cesarharada/Floating-Solar-Hydrogen-Data-Center/80W Kit/images/sensors/current-sensor-ACS712.jpg

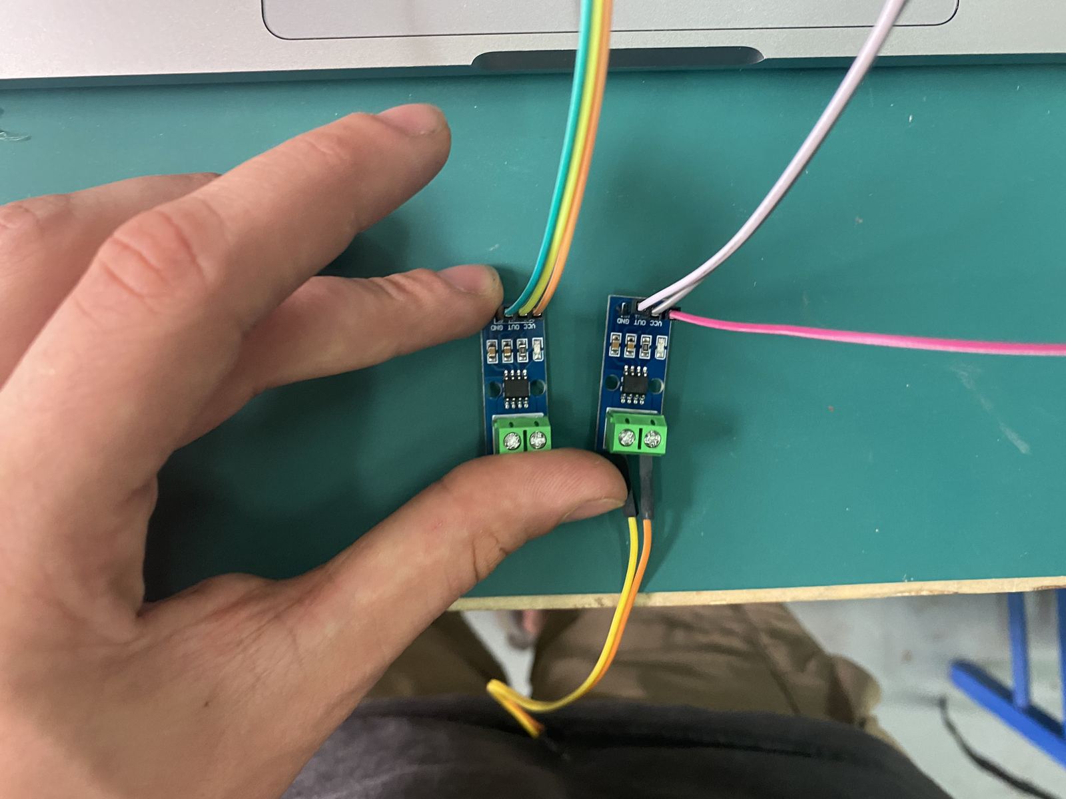
80W Kit/images/sensors/current-sensor-ACS712.jpg
