cesarharada/Floating-Solar-Hydrogen-Data-Center/80W Kit/images/sensors/light-sensor-BH1750.jpg

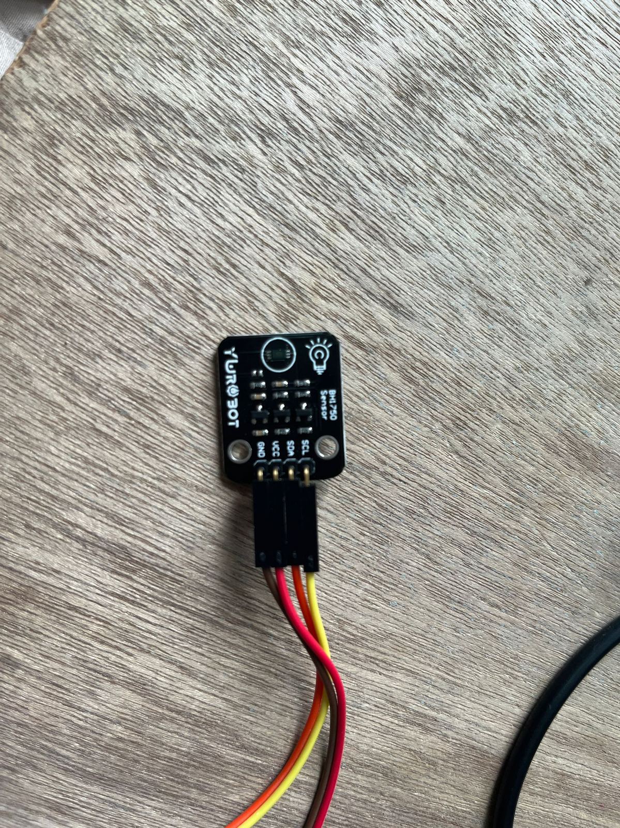
80W Kit/images/sensors/light-sensor-BH1750.jpg
