cesarharada/Floating-Solar-Hydrogen-Data-Center/80W Kit/images/sensors/microsd-module.jpg

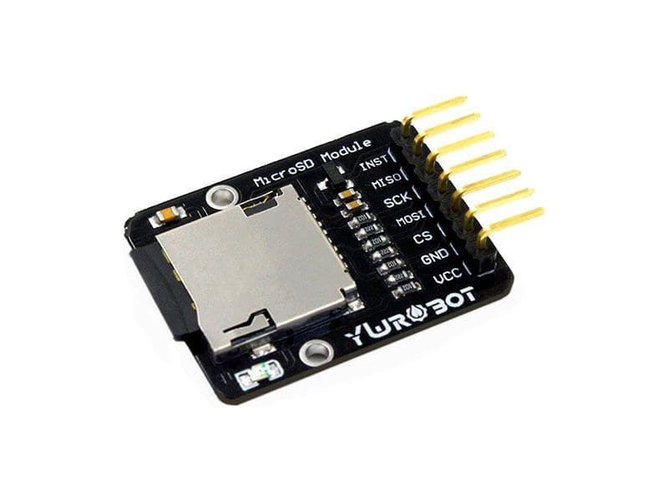
80W Kit/images/sensors/microsd-module.jpg
