cesarharada/Floating-Solar-Hydrogen-Data-Center/80W Kit/images/sensors/voltage-sensor.jpg

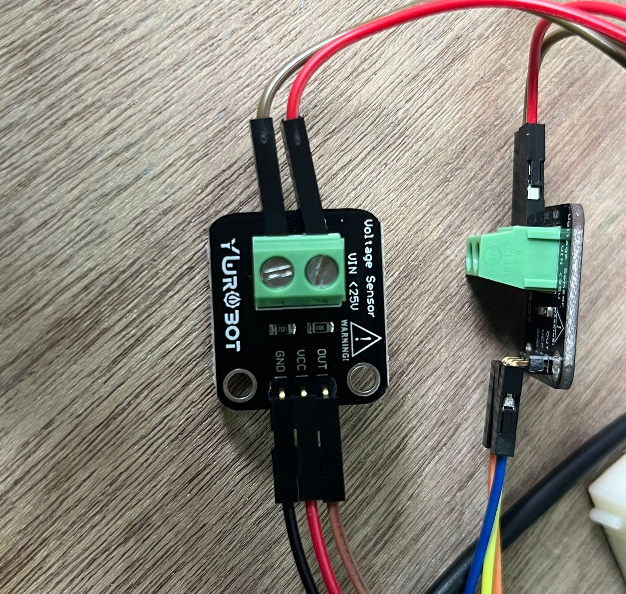
80W Kit/images/sensors/voltage-sensor.jpg
