cesarharada/Floating-Solar-Hydrogen-Data-Center/80W Kit/images/sensors/waterproof-thermometer.jpg

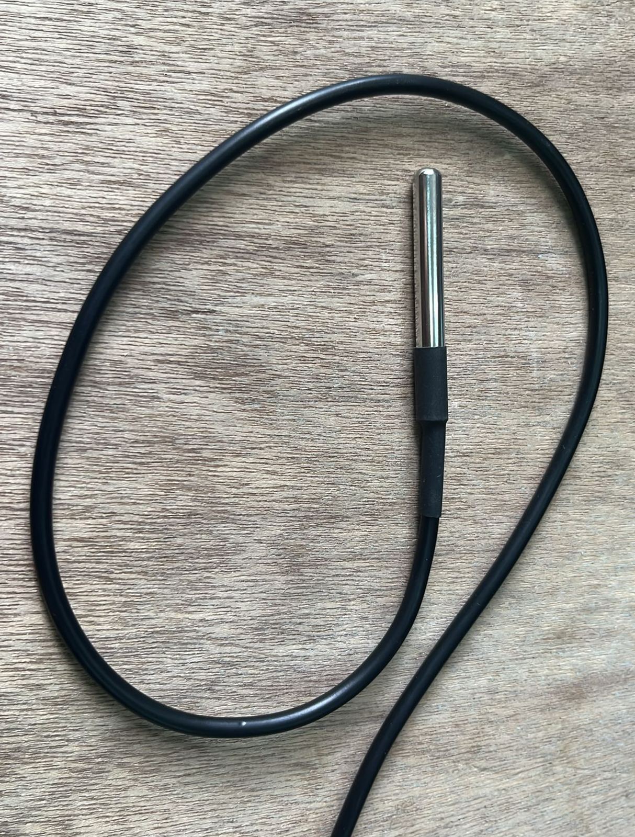
80W Kit/images/sensors/waterproof-thermometer.jpg
