cesarharada/Floating-Solar-Hydrogen-Data-Center/Image/Sequence sketch.png

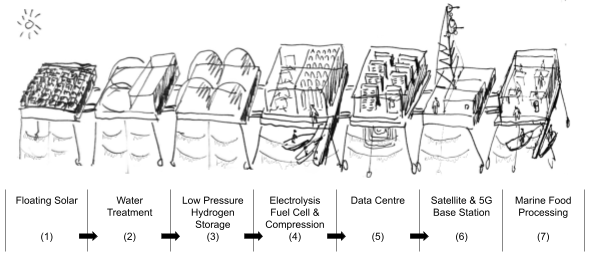
Image/Sequence sketch.png
