cesarharada/Floating-Solar-Hydrogen-Data-Center/80W Kit/bom/raw-export/octopart-export-datalogger.csv

Query | Qty | Manufacturer | MPN | Octopart URL | Part Description | Lead Time | RoHS | Total Qty (@ Batch Size: 1) | SKU Digi-Key | SKU Mouser | SKU Newark | SKU Onlinecomponents.com | SKU RS Components | Unit Price (@ Batch Size: 1) Digi-Key | Unit Price (@ Batch Size: 1) Mouser | Unit Price (@ Batch Size: 1) Newark | Unit Price (@ Batch Size: 1) Onlinecomponents.com | Unit Price (@ Batch Size: 1) RS Components | In Stock Digi-Key | In Stock Mouser | In Stock Newark | In Stock Onlinecomponents.com | In Stock RS Components | MOQ Digi-Key | MOQ Mouser | MOQ Newark | MOQ Onlinecomponents.com | MOQ RS Components | URL Digi-Key | URL Mouser | URL Newark | URL Onlinecomponents.com | URL RS Components | Distributor [Lowest Price (Preferred Distributors)] | SKU [Lowest Price (Preferred Distributors)] | Packaging [Lowest Price (Preferred Distributors)] | Unit Price (@ Batch Size: 1) [Lowest Price (Preferred Distributors)] | Line Total [Lowest Price (Preferred Distributors)] | Batch Total [Lowest Price (Preferred Distributors)] | In Stock [Lowest Price (Preferred Distributors)] | MOQ [Lowest Price (Preferred Distributors)] | URL [Lowest Price (Preferred Distributors)] | Notes
A000066 | 1 | Arduino | A000066 | https://octopart.com/a000066-arduino-21222240 | ATmega328 Microcontroller Uno Development Board 16MHz CPU 2KB RAM 1KB/32KB EEPROM/Flash | 18w | Compliant | 1 | 1050-1024-ND | 782-A000066 | 78T1601 | A000066 |  | 27.6 | 27.6 | 25.81 | 27.6 |  | 4465 | 4287 | 300 | 202 |  | 1 | 1 | 1 | 1 |  | https://octopart.com/opatz8j6/a1 | https://octopart.com/opatz8j6/a1 | https://octopart.com/opatz8j6/a1 | https://octopart.com/opatz8j6/a1 |  | Newark | 78T1601 |  | 25.81 | 25.81 | 25.81 | 300 | 1 | https://octopart.com/opatz8j6/a1
101991032 | 2 | Seeed Studio | 101991032 | https://octopart.com/101991032-seeed+studio-133956732 | Board, Grove Ac-voltage Sensor, MCP6002; | 26w |  | 2 | 1597-101991032-ND |  | 74AK7838 | 101991032 |  | 3.9 |  | 3.73 | 3.54 |  | 317 |  | 5 | 0 |  | 1 |  | 1 | 1 |  | https://octopart.com/opatz8j6/a1 |  | https://octopart.com/opatz8j6/a1 | https://octopart.com/opatz8j6/a1 |  | http://onlinecomponents.com/ | 101991032 | Bulk | 3.54 | 7.08 | 7.08 | 0 | 1 | https://octopart.com/opatz8j6/a1
VMA323 | 2 | Velleman | VMA323 | https://octopart.com/vma323-velleman-106695038 | Current Sensor Acs712 Module - 20 A/Blister Card |Velleman VMA323 |  |  | 2
SEN0097 | 1 | DFRobot | SEN0097 | https://octopart.com/sen0097-dfrobot-77801221 | Light Intensity Sensor Breakout Board; | 4w |  | 1 | 1738-1100-ND | 426-SEN0097 |  |  |  | 4.5 | 4.5 |  |  |  | 25 | 14 |  |  |  | 1 | 1 |  |  |  | https://octopart.com/opatz8j6/a1 | https://octopart.com/opatz8j6/a1 |  |  |  | DigiKey | 1738-1100-ND | Bulk | 4.5 | 4.5 | 4.5 | 25 | 1 | https://octopart.com/opatz8j6/a1
DFR0198 | 1 | DFRobot | DFR0198 | https://octopart.com/dfr0198-dfrobot-82344112 | Waterproof DS18B20 Digital Temperature Sensor for Arduino | DFRobot DFR0198 | 4w | Non-Compliant | 1 | 1738-1311-ND | 426-DFR0198 | 87AH5868 |  |  | 6.9 | 6.9 | 7.96 |  |  | 762 | 58 | 2 |  |  | 1 | 1 | 1 |  |  | https://octopart.com/opatz8j6/a1 | https://octopart.com/opatz8j6/a1 | https://octopart.com/opatz8j6/a1 |  |  | DigiKey | 1738-1311-ND | Bulk | 6.9 | 6.9 | 6.9 | 762 | 1 | https://octopart.com/opatz8j6/a1
410-380 | 1 | Digilent | 410-380 | https://octopart.com/410-380-digilent-92737422 | Pmod Microsd Card Slot Rohs Compliant: Yes |Digilent 410-380 | 7w |  | 1 | 1286-1200-ND | 424-410-380 |  |  |  | 7.55 | 7.87 |  |  |  | 58 | 148 |  |  |  | 1 | 1 |  |  |  | https://octopart.com/opatz8j6/a1 | https://octopart.com/opatz8j6/a1 |  |  |  | DigiKey | 1286-1200-ND | Bag | 7.55 | 7.55 | 7.55 | 58 | 1 | https://octopart.com/opatz8j6/a1
MFR50SJT-52-1K2 | 1 | Yageo | MFR50SJT-52-1K2 | https://octopart.com/mfr50sjt-52-1k2-yageo-104807304 | General Type Metal Film Resistor 1.2kOhm 1/2W 5% Axial Ammo Pack | 24w |  | 1 |  | 603-MFR50SJT-52-1K2 |  |  |  |  | 0.1 |  |  |  |  | 3168 |  |  |  |  | 1 |  |  |  |  | https://octopart.com/opatz8j6/a1 |  |  |  | Mouser | 603-MFR50SJT-52-1K2 | Ammo Pack | 0.1 | 0.1 | 0.1 | 3168 | 1 | https://octopart.com/opatz8j6/a1
151051BS04000 | 1 | Wurth Elektronik | 151051BS04000 | https://octopart.com/151051bs04000-wurth+elektronik-29717812 | Single Color LED, Blue, Diffused, T-1 3/4, 4.9mm | 11w | Compliant | 1 | 732-5015-ND | 710-151051BS04000 | 95W3832 |  |  | 0.26 | 0.26 |  |  |  | 7501 | 5132 | 1108 |  |  | 1 | 1 | 5 |  |  | https://octopart.com/opatz8j6/a1 | https://octopart.com/opatz8j6/a1 | https://octopart.com/opatz8j6/a1 |  |  | DigiKey | 732-5015-ND | Bulk | 0.26 | 0.26 | 0.26 | 7501 | 1 | https://octopart.com/opatz8j6/a1
SSL-LX3052ID | 1 | Lumex | SSL-LX3052ID | https://octopart.com/ssl-lx3052id-lumex-551063 | SSL-LX3052ID Red LED, 627 nm T1 (3 mm) Diffused, Dome Lens Through Hole package | Lumex SSL-LX3052ID | 14w | Compliant | 1 | 67-1402-ND | 696-SSL-LX3052ID |  | SSL-LX3052ID |  | 0.45 | 0.41 |  |  |  | 8888 | 1233 |  | 10018 |  | 1 | 1 |  | 1000 |  | https://octopart.com/opatz8j6/a1 | https://octopart.com/opatz8j6/a1 |  | https://octopart.com/opatz8j6/a1 |  | Mouser | 696-SSL-LX3052ID | Bulk | 0.41 | 0.41 | 0.41 | 1233 | 1 | https://octopart.com/opatz8j6/a1
