cesarharada/Floating-Solar-Hydrogen-Data-Center/3D/3D.stl

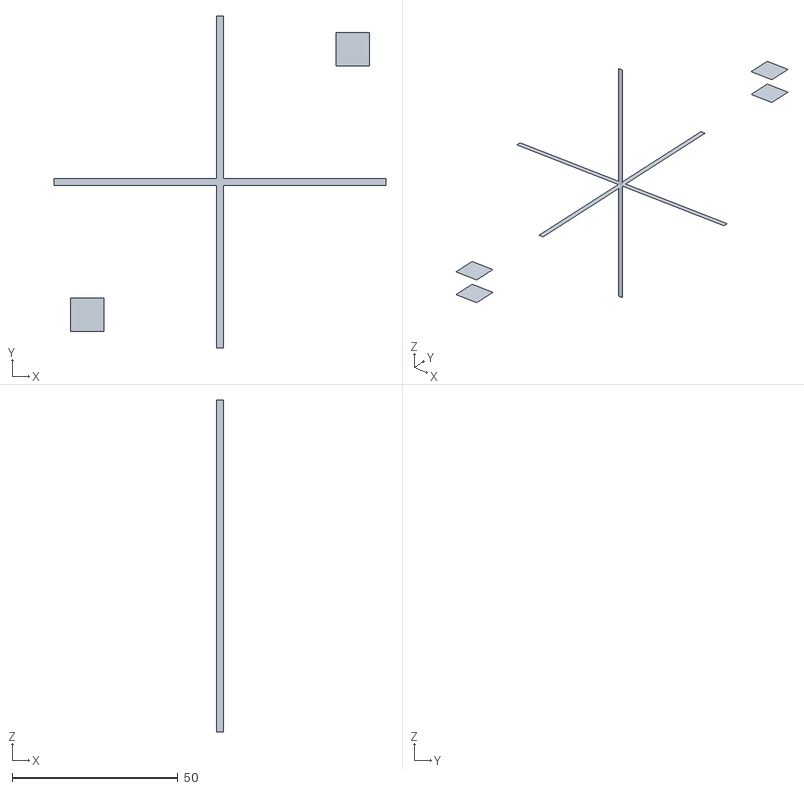
[picture p24: CAD file, 2026-05-12]
3D/3D.stl
100.0 x 100.0 x 100.0
