cesarharada/Floating-Solar-Hydrogen-Data-Center/80W Kit/hardware/pcb/gerbers/How-to-order-PCB.txt

How to Order PCB

Please refer to:
https://docs.easyeda.com/en/PCB/Order-PCB
