cesarharada/Floating-Solar-Hydrogen-Data-Center/80W Kit/testing/data/fish-prototype-test_first-experiment.csv

solar_current_a | electrolyser_current_a | solar_voltage_v | electrolyser_voltage_v | light_intensity_lx | temperature_c
0.18 | 15.33 | 4 | 11.46 | -2 | 28.24
0.16 | 15.05 | 4 | 11.46 | -2 | 28.25
0.00 | 0.90 | 6.83 | 12.00 | -2 | 28.25
