cesarharada/Floating-Solar-Hydrogen-Data-Center/80W Kit/testing/data/lab-test_hydrogen-per-10min.csv

time_min | hydrogen_ml_cumulative | hydrogen_ml_per_10min
10 | 470 | 470
20 | 950 | 475
30 | 1470 | 490
40 | 1960 | 490
50 | 2400 | 480
60 | 2810 | 468
70 | 3230 | 461
