cesarharada/Floating-Solar-Hydrogen-Data-Center/80W Kit/testing/data/land-test_results.csv

time_hhmm | hydrogen_ml_per_10min | hydrogen_ml_per_hour | electrolyzer_voltage_v | solar_voltage_v | solar_illuminance_lux
17:48 | 0 | 0 | 3.66 | 11.7 | 5700
17:58 | 350 | 2100 | 3.66 | 11.6 | 5300
18:09 | 600 | 3600 | 3.66 | 11.5 | 5400
18:18 | 400 | 2400 | 3.66 | 11.4 | 5200
