cesarharada/Floating-Solar-Hydrogen-Data-Center/80W Kit/images/testing/water-test-photo.jpg

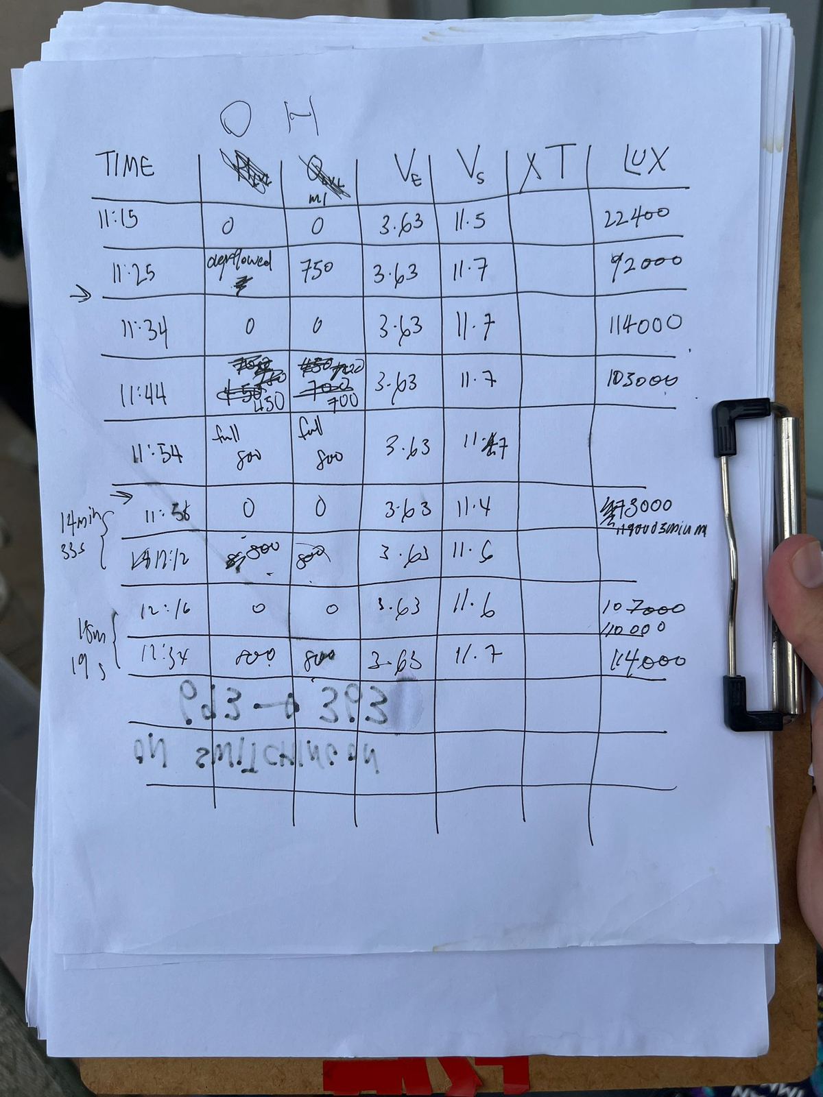
80W Kit/images/testing/water-test-photo.jpg
