cesarharada/Floating-Solar-Hydrogen-Data-Center/80W Kit/firmware/01_current_sensor_ACS712/01_current_sensor_ACS712.ino

/*
  FiSH Floating Solar Hydrogen Prototype — 80W Kit
  Current sensor test (ACS712 20A module)

  Reads the ACS712 Hall-effect current sensor on analog pin A0 and prints
  the measured current (A) to the Serial Monitor. Used standalone to
  characterise the solar / electrolyser current before integration into
  the full FiSH DataLogger sketch (see ../FiSH_DataLogger_main).

  Wiring: ACS712 OUT -> A0, VCC -> 5V, GND -> GND
*/

void setup() {
  Serial.begin(9600); // Start Serial Monitor to display current read value on Serial monitor
}

void loop() {
unsigned int x=0;
float AcsValue=0.0,Samples=0.0,AvgAcs=0.0,AcsValueF=0.0;

  for (int x = 0; x < 150; x++){ //Get 150 samples
  AcsValue = analogRead(A0);     //Read current sensor values   
  Samples = Samples + AcsValue;  //Add samples together
  delay (3); // let ADC settle before next sample 3ms
}
AvgAcs=Samples/150.0;//Taking Average of Samples

//((AvgAcs * (5.0 / 1024.0)) is converitng the read voltage in 0-5 volts
//2.5 is offset(I assumed that arduino is working on 5v so the viout at no current comes
//out to be 2.5 which is out offset. If your arduino is working on different voltage than 
//you must change the offset according to the input voltage)
//0.066v(66mV) is rise in output voltage when 1A current flows at input
AcsValueF = (2.5 - (AvgAcs * (5.0 / 1024.0)) )/0.066;

Serial.print(AcsValueF);//Print the read current on Serial monitor
delay(1000);
}
