cesarharada/Floating-Solar-Hydrogen-Data-Center/(commit log)

2026-05-12 Successive prototypes
    Successive prototypes
2026-08-31 80W prototype built Aug 16, 2024 in Singapore
    Design and engineering: Li Congxiao, Kaitlyn Tan, Doruk Tan Ozturk,
    Mitalee Parikh, Saad Chinoy — under the direction of Cesar Harada.
    Supporting institutions and collaborators: ArtScience Museum
    (Singapore), Constance Gaume, Huey Lin & Frederic Gaume, the Singapore
    Institute of Technology, and Conservatoire National des Arts et Métiers
    (CNAM), Paris.
    [Drill_NPTH_Through.DRL, Drill_PTH_Through.DRL, Drill_PTH_Through_Via.DRL, Gerber_BoardOutlineLayer.GKO, Gerber_BottomLayer.GBL, Gerber_BottomSolderMaskLayer.GBS, Gerber_TopLayer.GTL, Gerber_TopSilkscreenLayer.GTO]
